yacoolmisaka/sky130-Two-Stage-Miller-OTA/简历项目介绍.md

# SkyWater 130nm 两级 Miller 补偿 OTA

> 作者：桂耀翔
> 定位：IC 版图工程师（模拟/混合信号方向）
> 工艺：SkyWater SKY130 (130nm) 开源 PDK
> 工具链：ngspice / xschem / Magic / netgen / KLayout（全开源）
> 状态：**全流程闭环**（规格 → 前仿 → 版图 → 签核 → 后仿），收官 2026-09-22

---

## 一、一句话

在开源 130nm 工艺上，独立完成两级 Miller 补偿 OTA 的全流程：手算尺寸 → 原理图 → 前仿达标 → Magic 版图 → DRC/LVS 签核 → 含寄生后仿。

---

## 二、电路参数

### 拓扑

- 第一级：M1/M2 NMOS 差分输入对 + M3/M4 PMOS 电流镜负载 + M5 尾电流源
- 第二级：M6 PMOS 共源放大 + M7 NMOS 电流沉
- 补偿：Cc 1.2 pF 串联 Rz 3 kΩ（把 RHP 零点推到左半平面）
- 偏置：外部 10 µA 基准 → Mref 二极管接法 → vbias → M5/M7 镜像
- 电源：1.8 V；负载：2 pF

### 器件尺寸

| 器件 | 类型 | 等效总宽 | L | 指 / 倍数 |
|---|---|---|---|---|
| M1, M2 | NMOS | 4 µm | 1 µm | 2 指 |
| M3, M4 | PMOS | 4 µm | 1 µm | 2 指 |
| M5 | NMOS | 24 µm | 1 µm | 12 指 |
| M6 | PMOS | 56 µm | 1 µm | 28 指 |
| M7 | NMOS | 62.5 µm | 1 µm | 25 指 |
| Mref | NMOS | 12.5 µm | 1 µm | 5 指 |
| Cc | MIM 电容 | 24.3 × 24.3 µm（≈1.2 pF） | — | — |
| Rz | 高阻 poly | W 0.69 µm / L 1.035 µm（≈3 kΩ） | — | — |

### 版图参数

| 项 | 值 |
|---|---|
| 顶层单元 | `ota2_miller` |
| 器件数 | 10 |
| 整体尺寸 | 88 µm |
| 布线层 | metal1 ~ metal4（VDD 走 metal1 / GND 走 metal2） |
| 特殊结构 | 输出节点 via2+via3 叠放、补偿节点 via1+via2 叠放 |
| GDS | 9 cell / 14 层号 / 约 7300 shape |

---

## 三、成绩单

### 前仿（8 项全达标）

| 指标 | 目标 | 实测 |
|---|---|---|
| 开环增益 Av | ≥ 60 dB | **72.65 dB** |
| 单位增益带宽 GBW | 10 ~ 20 MHz | **10.39 MHz** |
| 相位裕度 PM | ≥ 60° | **63.28°** |
| 压摆率 SR | ≥ 10 V/µs | **+14.1 / −12.3 V/µs** |
| 静态功耗 | ≤ 150 µW | **139.7 µW** |
| 输入共模范围 | 0.78 ~ 1.45 V | **0.21 ~ 1.80 V** |
| 阶跃过冲 | 小 | **0.0 %** |
| 工作区 | 全部饱和 | **8/8 饱和** |

### 原理图 ↔ 网表交叉验证

| 指标 | 手写网表 | 原理图导出网表 | 偏差 |
|---|---|---|---|
| Av | 72.65 dB | 72.649 dB | 0.001 dB |
| GBW | 10.39 MHz | 10.41 MHz | +0.2 % |
| PM | 63.28° | 64.37° | +1.09° |

### 签核

| 项 | 工具 | 结果 |
|---|---|---|
| LVS | netgen | **Circuits match uniquely.**（10 器件 / 10 网） |
| DRC | KLayout 官方 `sky130A_mr.drc` | **0 违规** |
| DRC | Magic | 132 → 68 项（剩余为 PDK 器件生成器固有几何） |

### 含寄生后仿

| 指标 | 前仿 | 后仿 | 变化 |
|---|---|---|---|
| Av | 72.65 dB | **72.65 dB** | 持平 |
| GBW | 10.39 MHz | **9.92 MHz** | −4.5 % |
| PM | 63.28° | **64.56°** | +1.28° |

---

## 四、关键操作

```bash
# 前仿
bash 04_sim/run.sh ac

# 版图：magic tkcon 内
source 05_layout/run_lvs.tcl     # 应用修正 → 提取 → 导出网表
source 05_layout/run_gds.tcl     # 导出 GDS
source 05_layout/run_pext.tcl    # 导出含寄生网表（须新开会话）

# LVS / DRC / 后仿
bash run_netgen.sh
bash run_drc.sh
bash run_postsim.sh
```

---

## 五、文件索引

| 路径 | 内容 |
|---|---|
| `01_spec/` `02_sizing/` | 设计规格、手算 sizing 脚本与结果 |
| `03_sch/` | xschem 原理图、网表、接线核验 |
| `04_sim/` | 测试台、模型指向、仿真一键脚本、波特图 |
| `05_layout/` | 版图脚本（TCL / Python）、`mag/` 版图源与 GDS |
| `05_layout/docs/` | 版图与 DRC/LVS 过程记录（10 份） |
| `docs/工程全流程复盘.md` | 全流程复盘 + 技术问答 |
| `README.md` | 项目总览 |
| `lvs*.log` | 13 轮 LVS 迭代日志（含失败轮次，最终版为 `lvs_report.log`） |
| `drc_klayout.txt` | KLayout 签核 DRC 报告 |
