yacoolmisaka/sky130-Two-Stage-Miller-OTA/Screenshot/9.10/AC增益.png

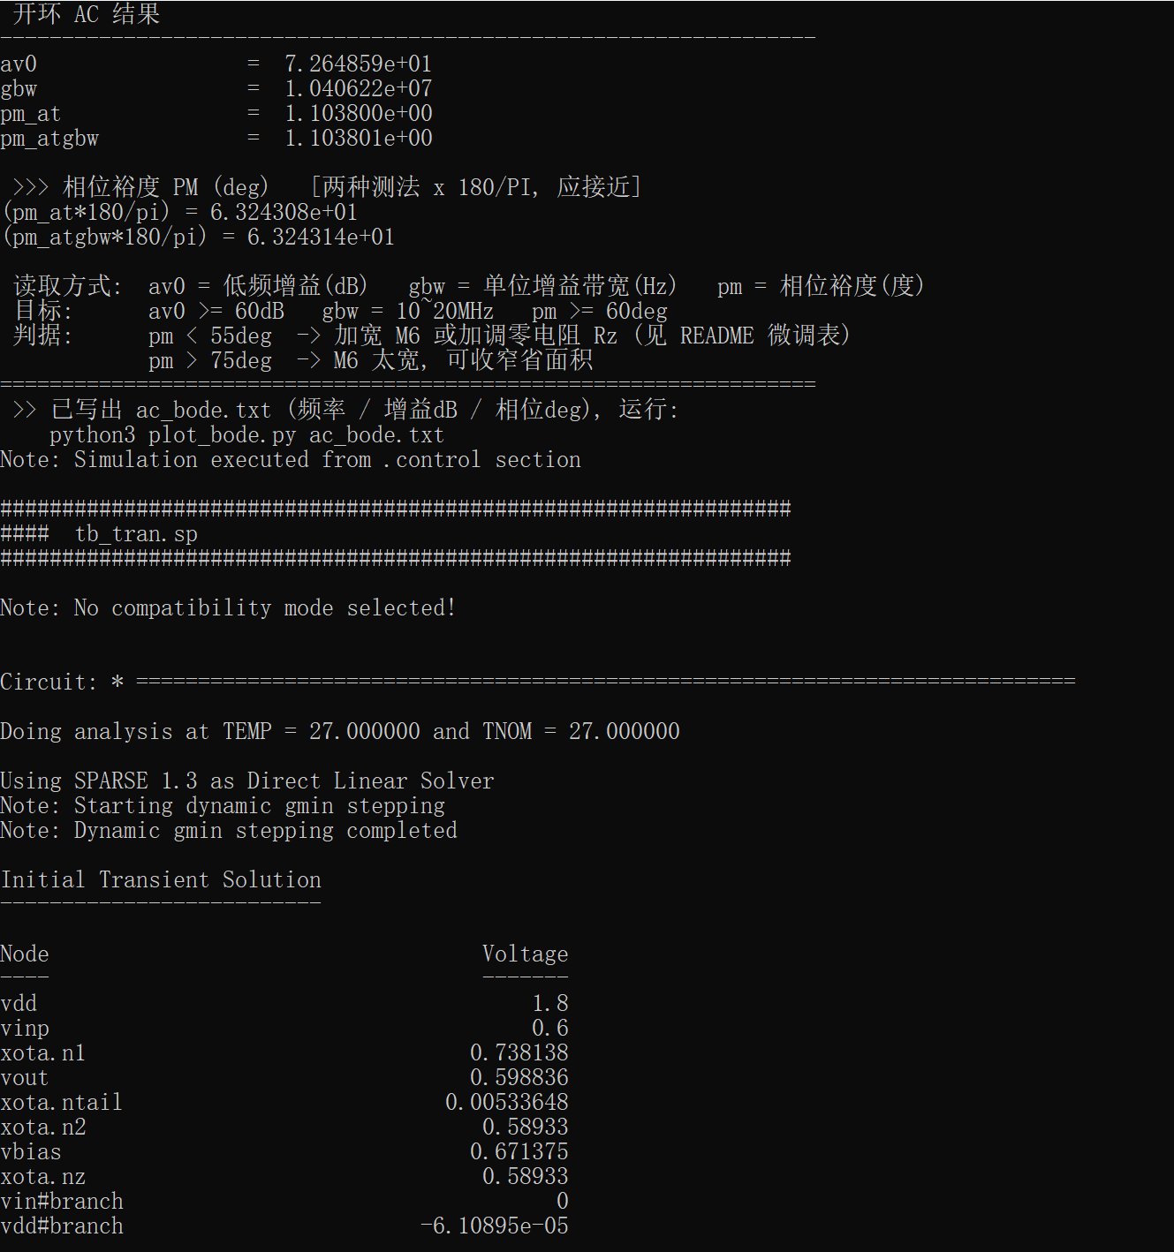
Screenshot/9.10/AC增益.png
