yacoolmisaka/sky130-Two-Stage-Miller-OTA/Screenshot/9.10/OP 工作点2.png

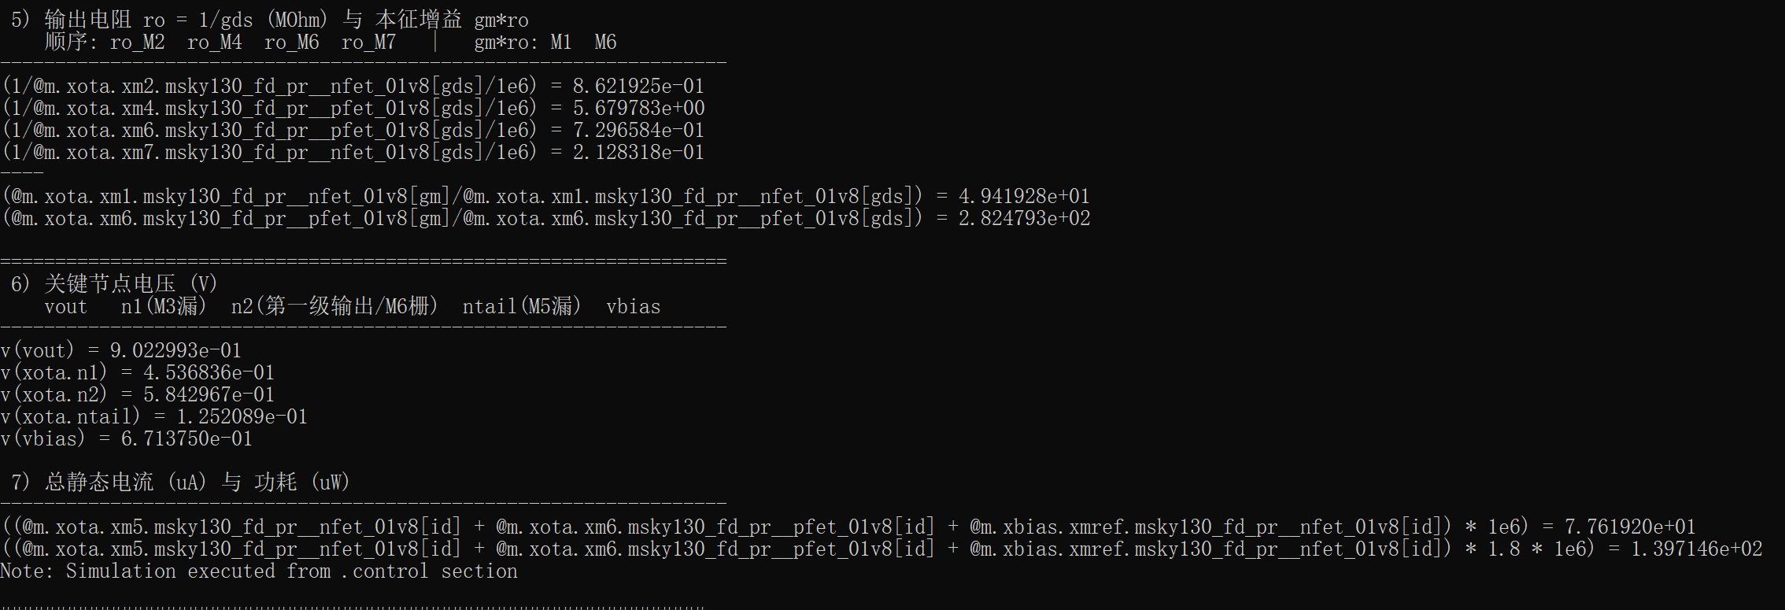
Screenshot/9.10/OP 工作点2.png
