yacoolmisaka/sky130-Two-Stage-Miller-OTA/Screenshot/9.10/PM验算_ICMR报告.png

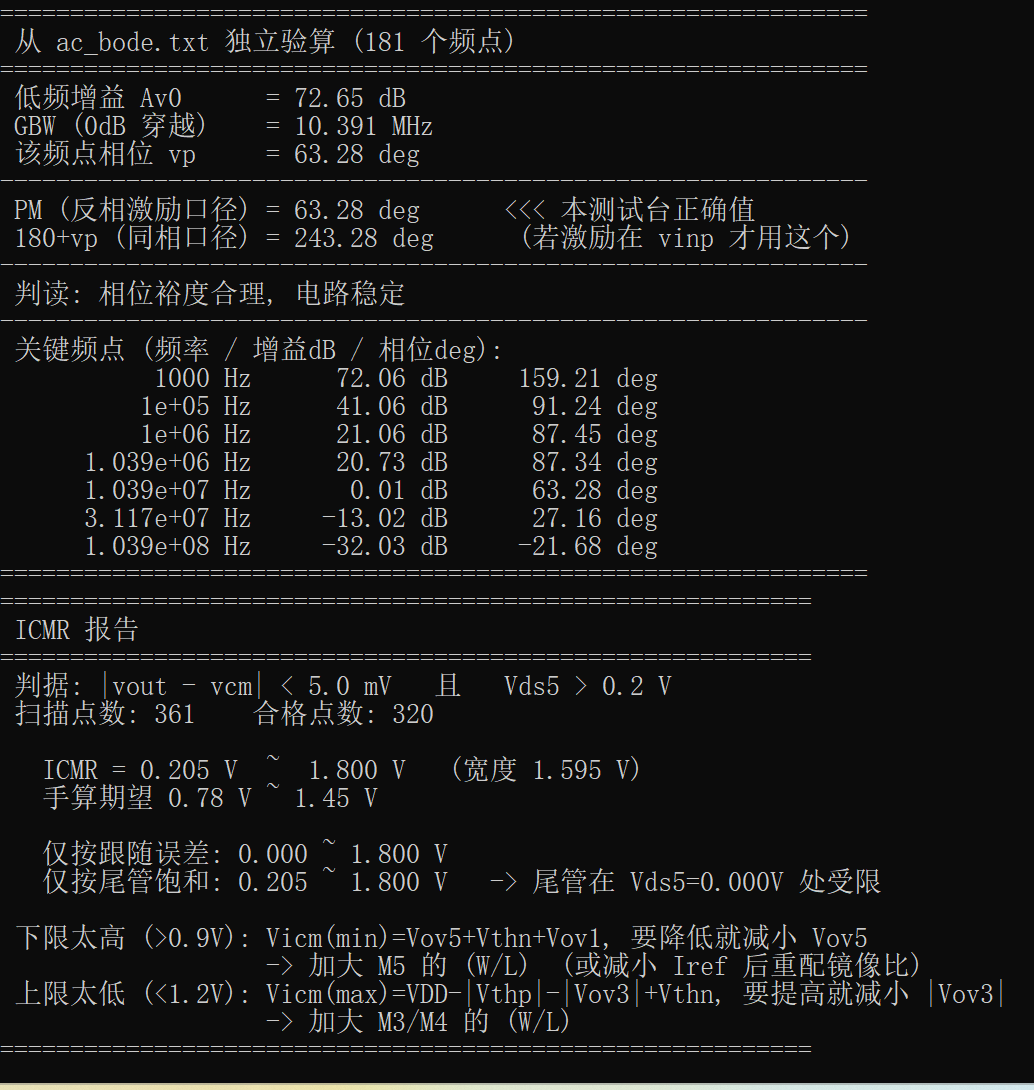
Screenshot/9.10/PM验算_ICMR报告.png
