yacoolmisaka/sky130-Two-Stage-Miller-OTA/Screenshot/9.10/前仿1.png

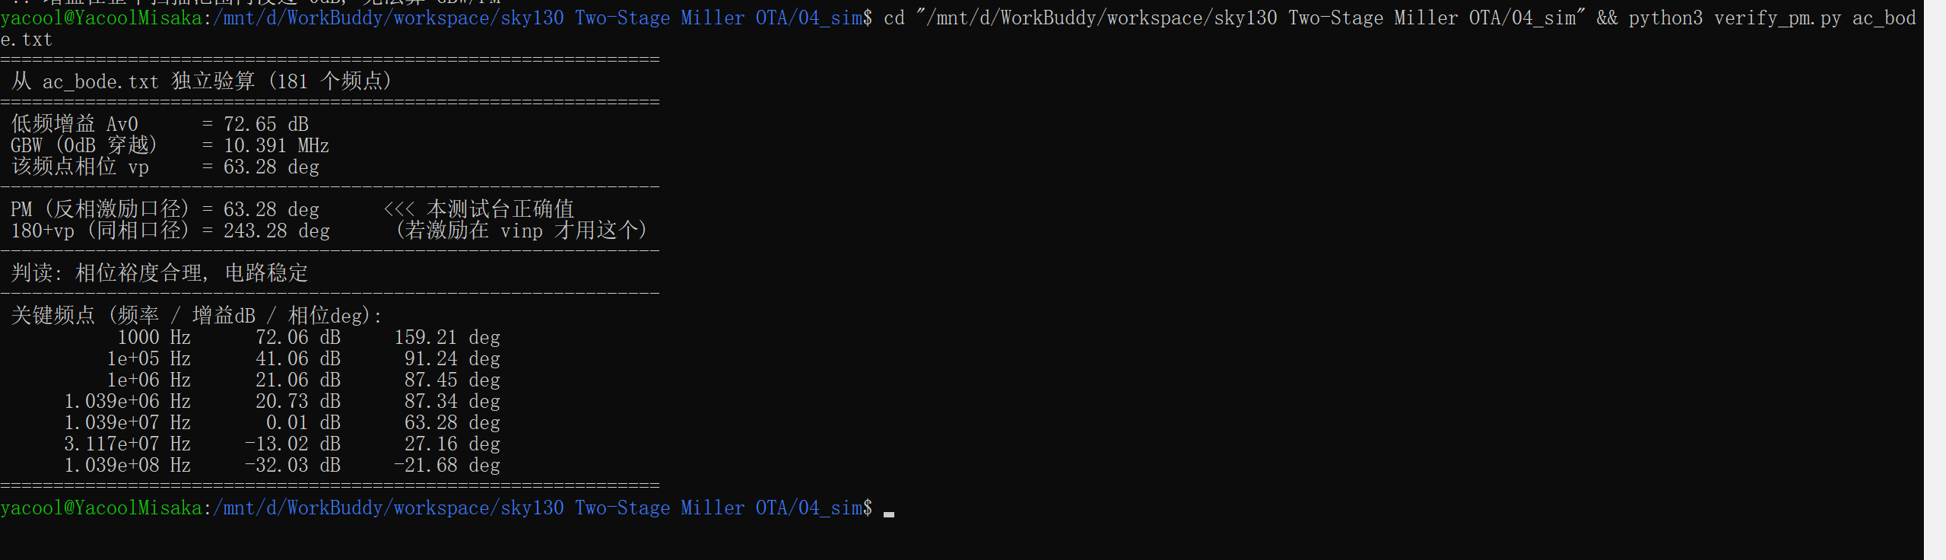
Screenshot/9.10/前仿1.png
