yacoolmisaka/sky130-Two-Stage-Miller-OTA/Screenshot/9.10/前仿2.png

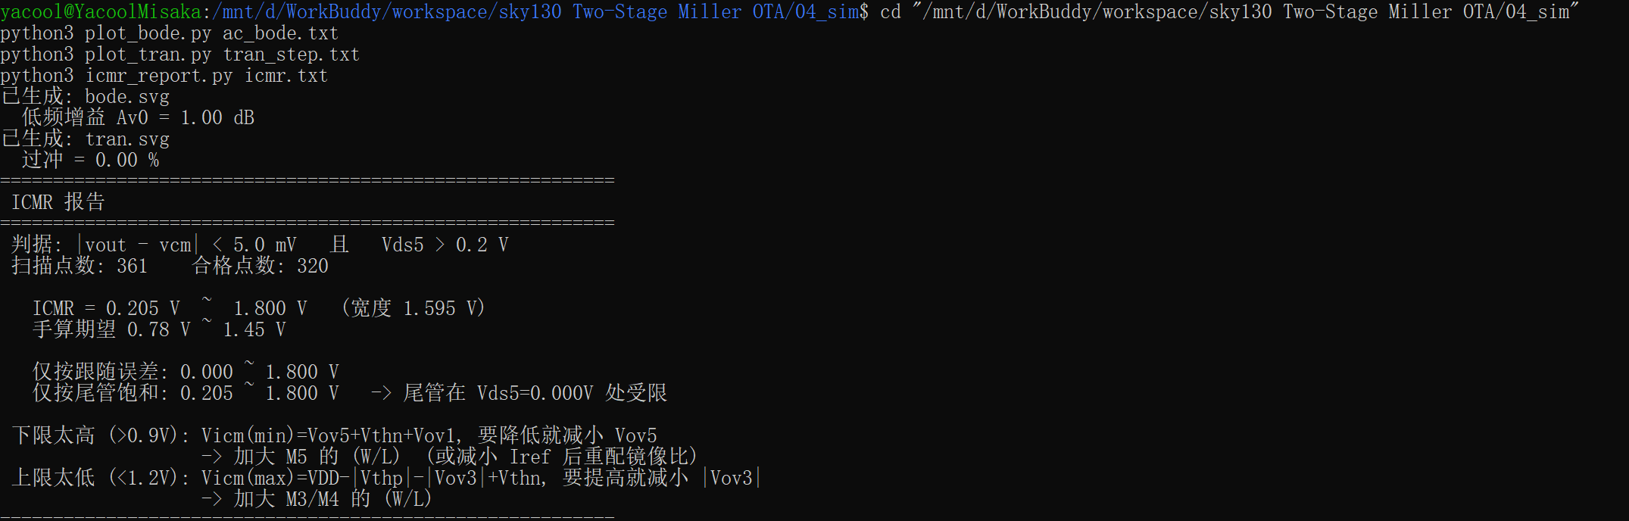
Screenshot/9.10/前仿2.png
