yacoolmisaka/sky130-Two-Stage-Miller-OTA/Screenshot/9.10/屏幕截图 2026-09-10 223026.png

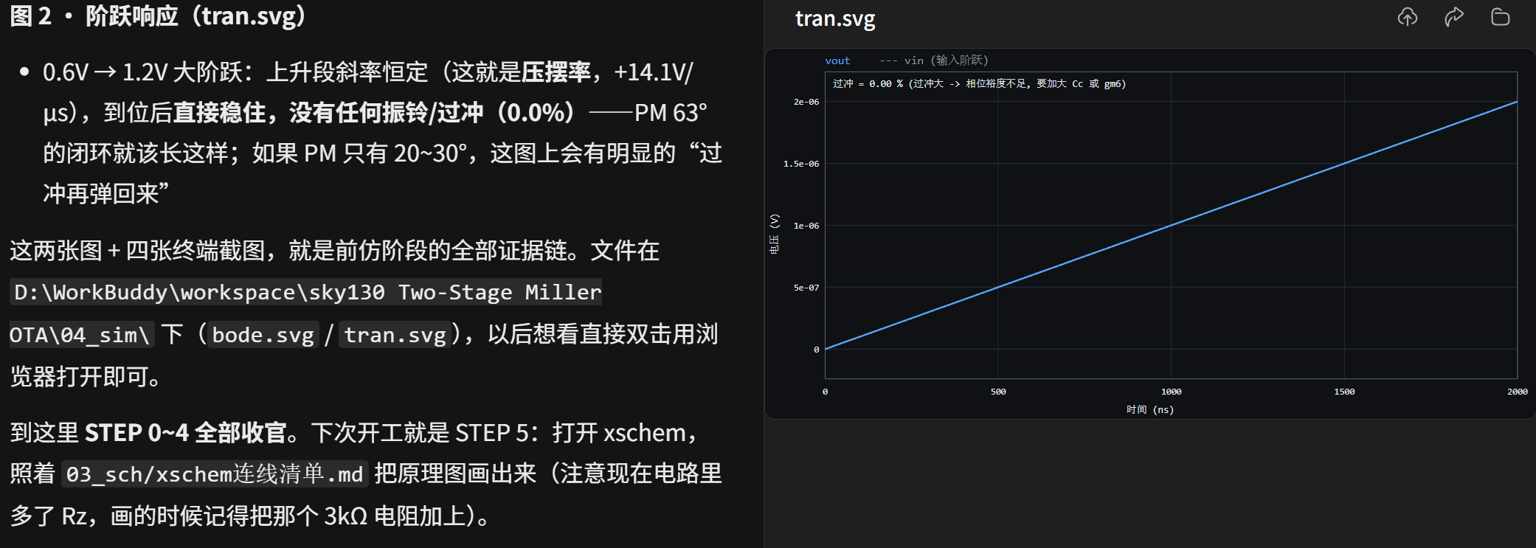
Screenshot/9.10/屏幕截图 2026-09-10 223026.png
