yacoolmisaka/sky130-Two-Stage-Miller-OTA/Screenshot/9.10/电流倍增因子.png

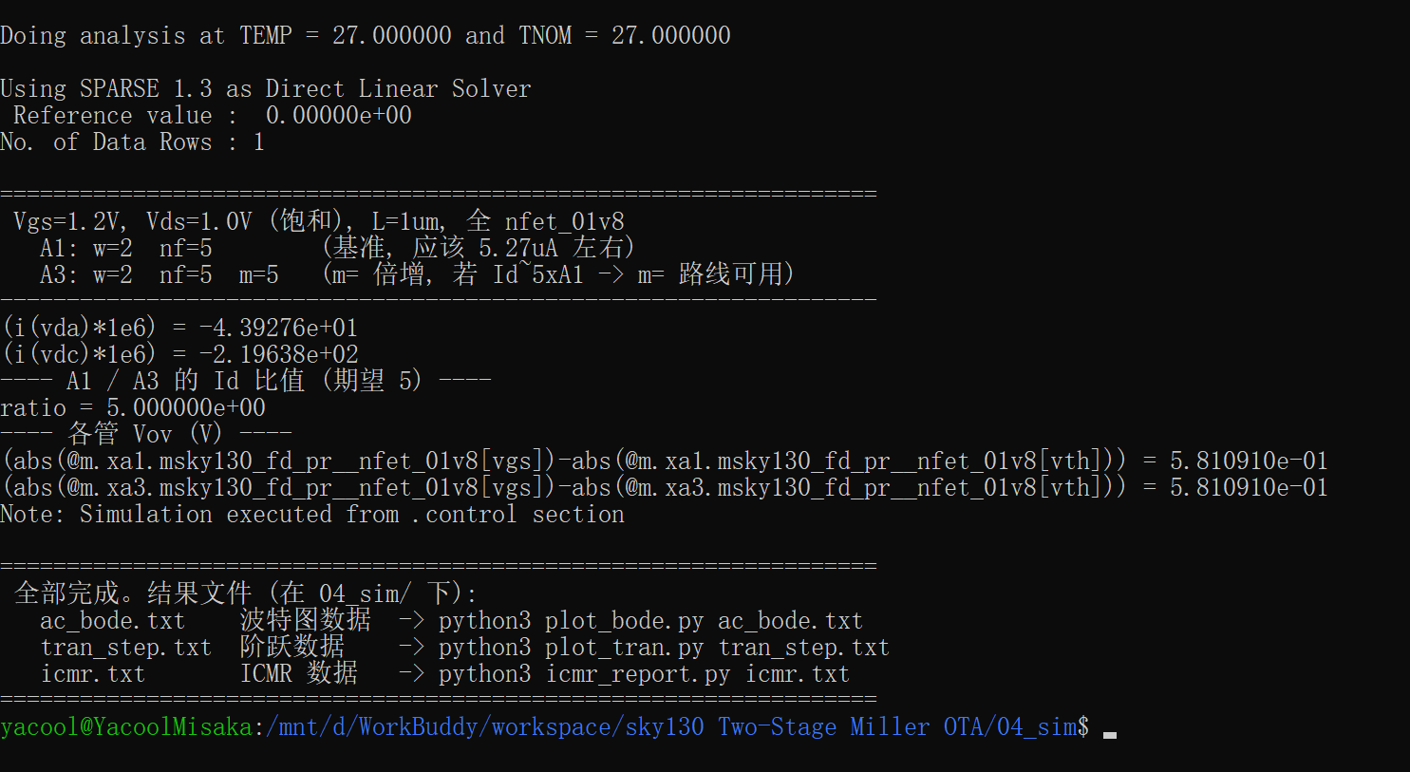
Screenshot/9.10/电流倍增因子.png
