yacoolmisaka/sky130-Two-Stage-Miller-OTA/Screenshot/9.16/xschem画原理图.png

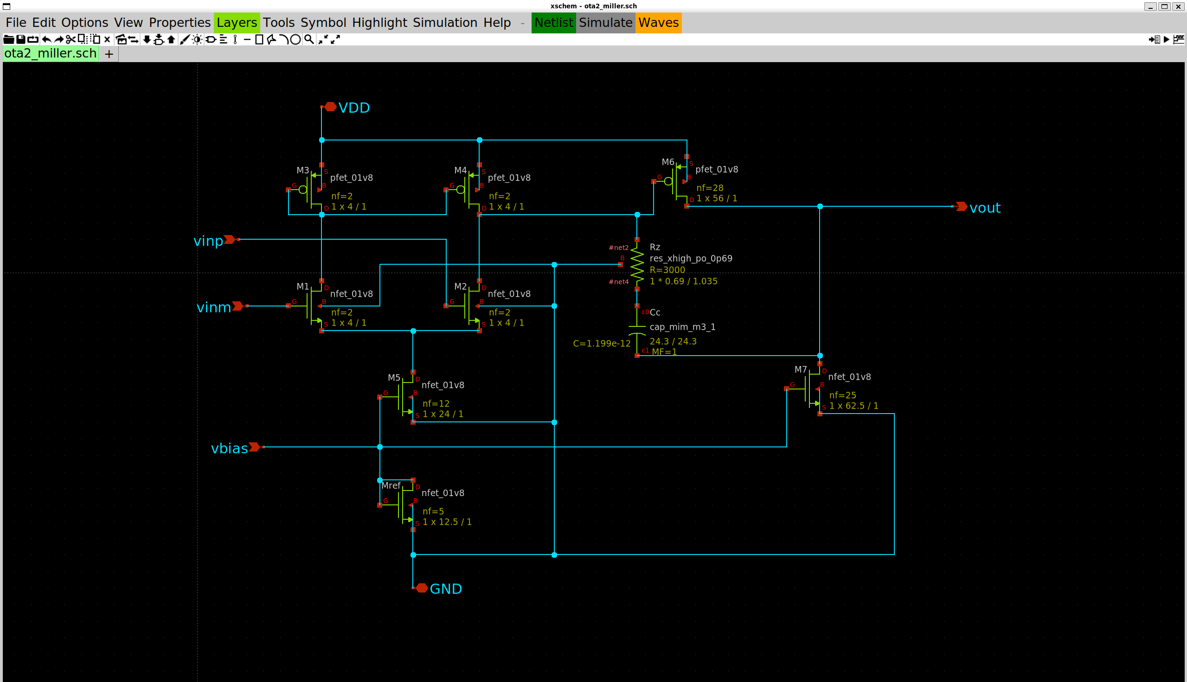
Screenshot/9.16/xschem画原理图.png
