yacoolmisaka/sky130-Two-Stage-Miller-OTA/Screenshot/9.16/交叉验证1.png

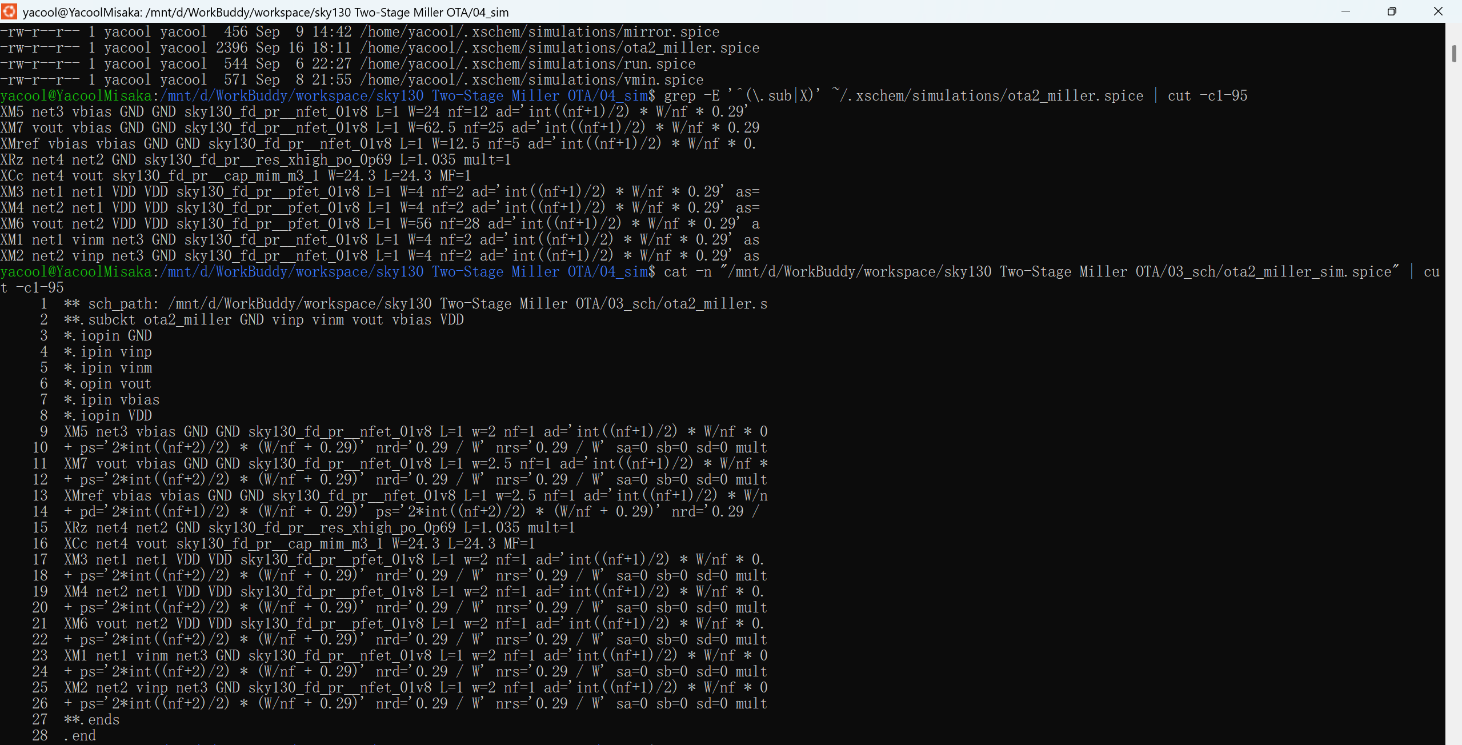
Screenshot/9.16/交叉验证1.png
