yacoolmisaka/sky130-Two-Stage-Miller-OTA/Screenshot/9.16/交叉验证2.png

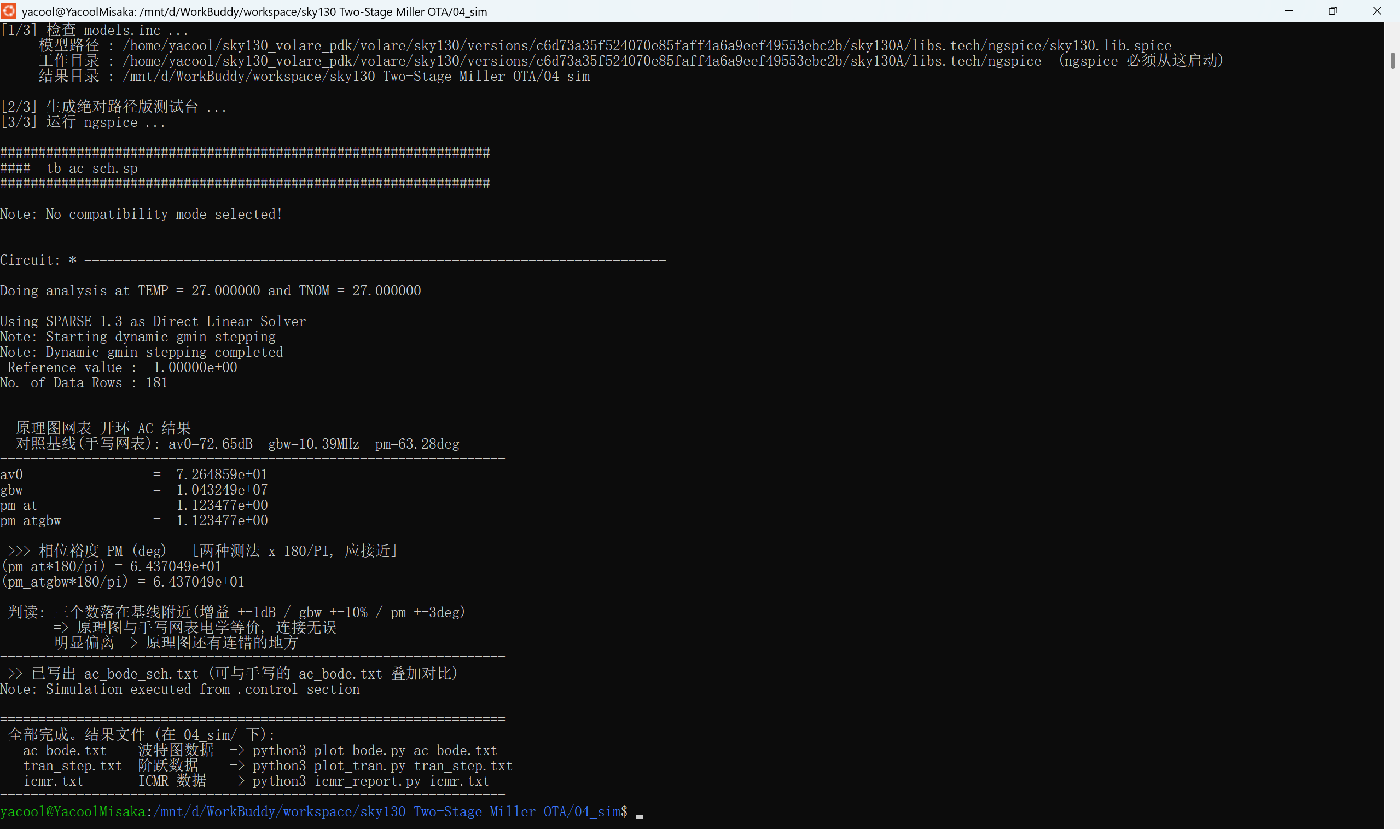
Screenshot/9.16/交叉验证2.png
