yacoolmisaka/sky130-Two-Stage-Miller-OTA/Screenshot/9.19/屏幕截图 2026-09-21 234536.png

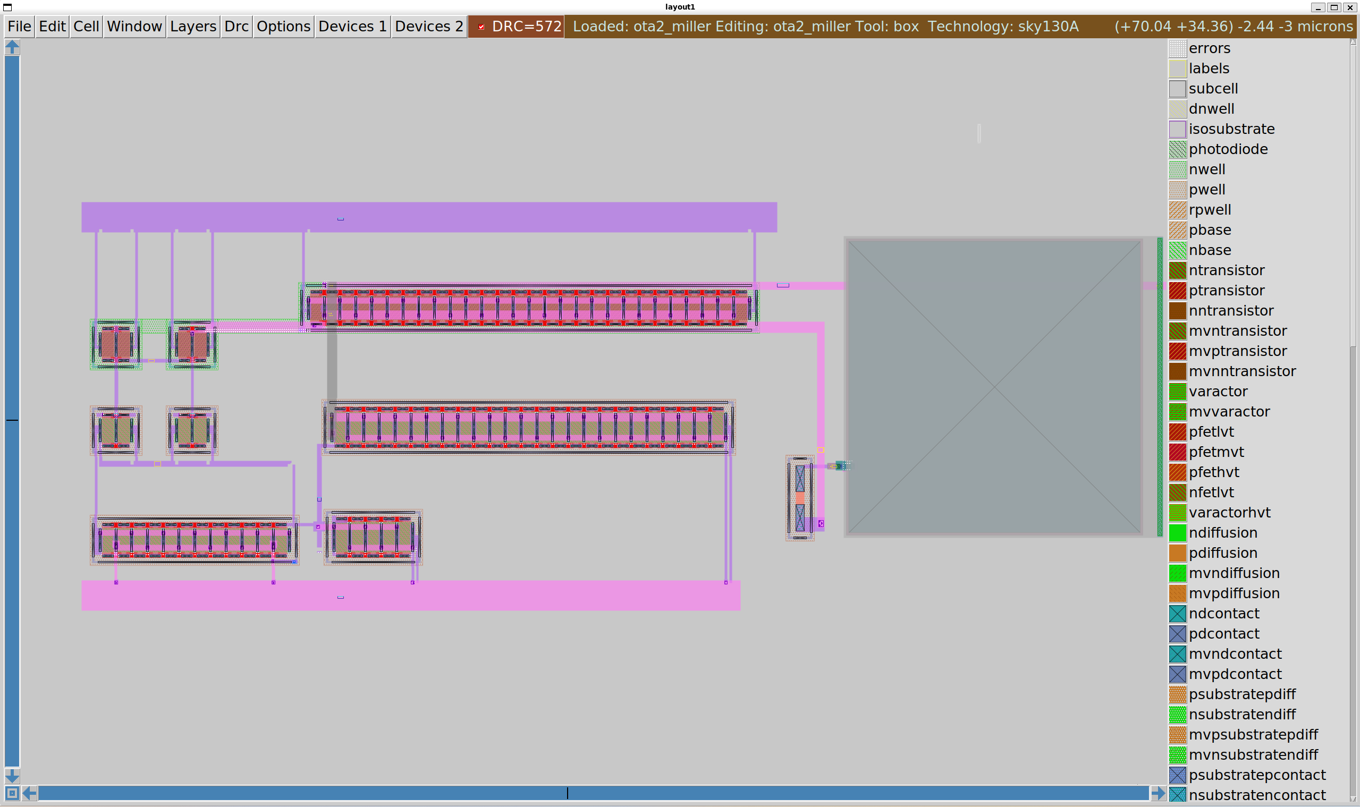
Screenshot/9.19/屏幕截图 2026-09-21 234536.png
