yacoolmisaka/sky130-Two-Stage-Miller-OTA/Screenshot/9.21/屏幕截图 2026-09-21 234447.png

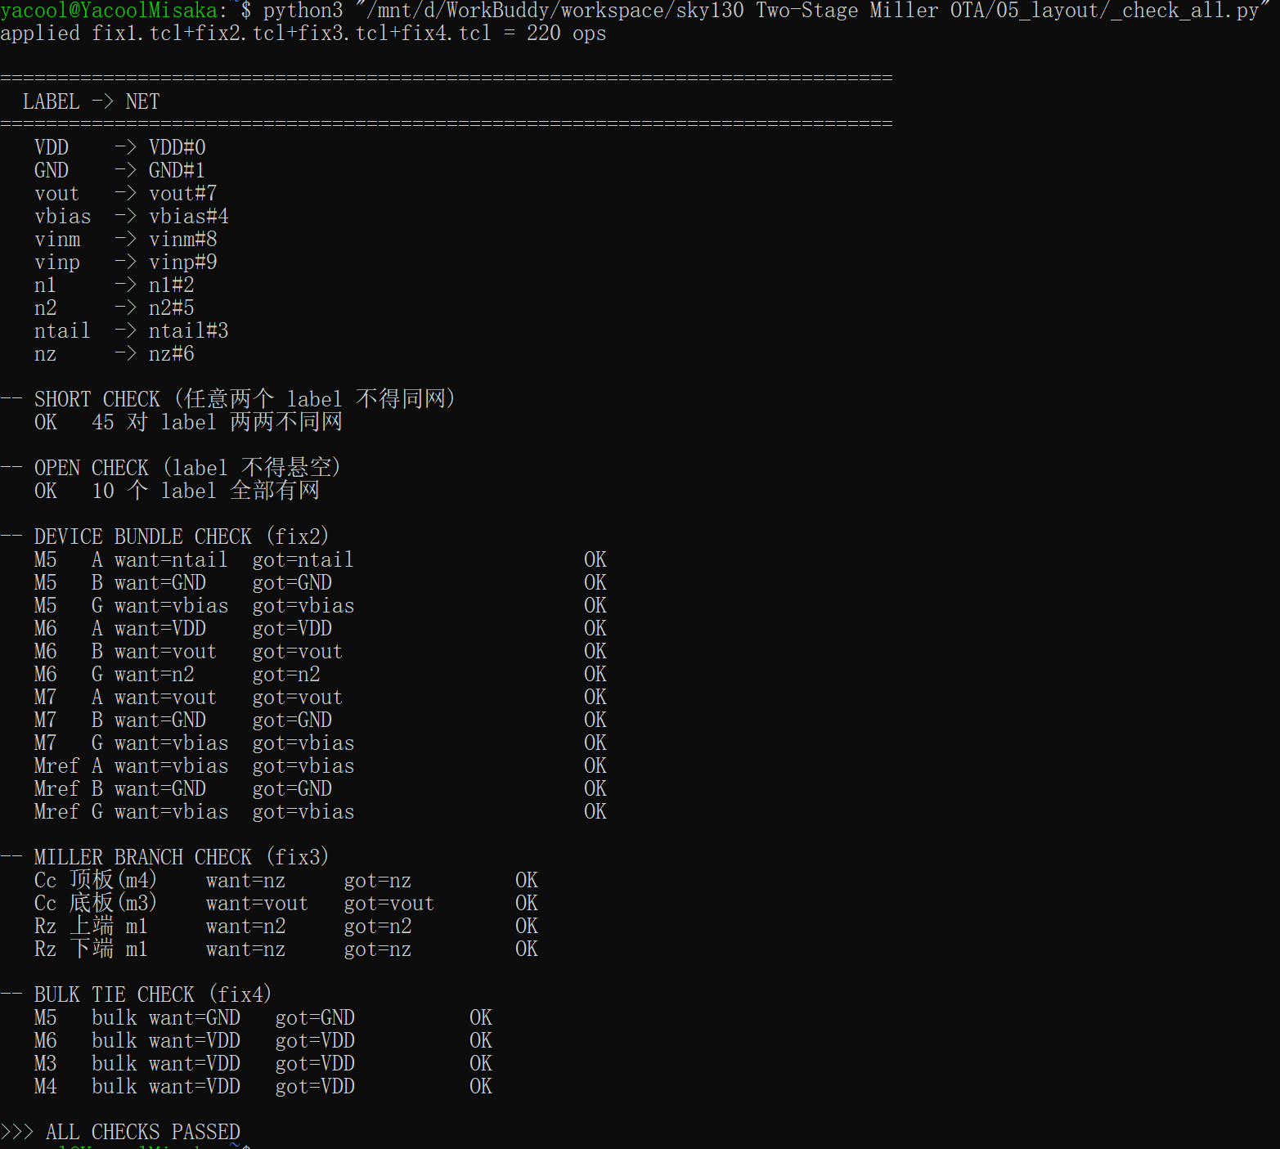
Screenshot/9.21/屏幕截图 2026-09-21 234447.png
