yacoolmisaka/sky130-Two-Stage-Miller-OTA/04_sim/tran_step.txt

 0.00000000e+00  0.00000000e+00  0.00000000e+00  5.98836197e-01  0.00000000e+00  6.00000000e-01 
 5.00000000e-11  5.00000000e-11  5.00000000e-11  5.98836197e-01  5.00000000e-11  6.00000000e-01 
 1.00000000e-10  1.00000000e-10  1.00000000e-10  5.98836197e-01  1.00000000e-10  6.00000000e-01 
 2.00000000e-10  2.00000000e-10  2.00000000e-10  5.98836197e-01  2.00000000e-10  6.00000000e-01 
 4.00000000e-10  4.00000000e-10  4.00000000e-10  5.98836197e-01  4.00000000e-10  6.00000000e-01 
 8.00000000e-10  8.00000000e-10  8.00000000e-10  5.98836197e-01  8.00000000e-10  6.00000000e-01 
 1.60000000e-09  1.60000000e-09  1.60000000e-09  5.98836197e-01  1.60000000e-09  6.00000000e-01 
 3.20000000e-09  3.20000000e-09  3.20000000e-09  5.98836197e-01  3.20000000e-09  6.00000000e-01 
 6.40000000e-09  6.40000000e-09  6.40000000e-09  5.98836197e-01  6.40000000e-09  6.00000000e-01 
 1.14000000e-08  1.14000000e-08  1.14000000e-08  5.98836197e-01  1.14000000e-08  6.00000000e-01 
 1.64000000e-08  1.64000000e-08  1.64000000e-08  5.98836197e-01  1.64000000e-08  6.00000000e-01 
 2.14000000e-08  2.14000000e-08  2.14000000e-08  5.98836197e-01  2.14000000e-08  6.00000000e-01 
 2.64000000e-08  2.64000000e-08  2.64000000e-08  5.98836197e-01  2.64000000e-08  6.00000000e-01 
 3.14000000e-08  3.14000000e-08  3.14000000e-08  5.98836197e-01  3.14000000e-08  6.00000000e-01 
 3.64000000e-08  3.64000000e-08  3.64000000e-08  5.98836197e-01  3.64000000e-08  6.00000000e-01 
 4.14000000e-08  4.14000000e-08  4.14000000e-08  5.98836197e-01  4.14000000e-08  6.00000000e-01 
 4.64000000e-08  4.64000000e-08  4.64000000e-08  5.98836197e-01  4.64000000e-08  6.00000000e-01 
 5.14000000e-08  5.14000000e-08  5.14000000e-08  5.98836197e-01  5.14000000e-08  6.00000000e-01 
 5.64000000e-08  5.64000000e-08  5.64000000e-08  5.98836197e-01  5.64000000e-08  6.00000000e-01 
 6.14000000e-08  6.14000000e-08  6.14000000e-08  5.98836197e-01  6.14000000e-08  6.00000000e-01 
 6.64000000e-08  6.64000000e-08  6.64000000e-08  5.98836197e-01  6.64000000e-08  6.00000000e-01 
 7.14000000e-08  7.14000000e-08  7.14000000e-08  5.98836197e-01  7.14000000e-08  6.00000000e-01 
 7.64000000e-08  7.64000000e-08  7.64000000e-08  5.98836197e-01  7.64000000e-08  6.00000000e-01 
 8.14000000e-08  8.14000000e-08  8.14000000e-08  5.98836197e-01  8.14000000e-08  6.00000000e-01 
 8.64000000e-08  8.64000000e-08  8.64000000e-08  5.98836197e-01  8.64000000e-08  6.00000000e-01 
 9.14000000e-08  9.14000000e-08  9.14000000e-08  5.98836197e-01  9.14000000e-08  6.00000000e-01 
 9.64000000e-08  9.64000000e-08  9.64000000e-08  5.98836197e-01  9.64000000e-08  6.00000000e-01 
 1.00000000e-07  1.00000000e-07  1.00000000e-07  5.98836197e-01  1.00000000e-07  6.00000000e-01 
 1.00500000e-07  1.00500000e-07  1.00500000e-07  5.98818990e-01  1.00500000e-07  6.15000000e-01 
 1.01500000e-07  1.01500000e-07  1.01500000e-07  5.98735097e-01  1.01500000e-07  6.45000000e-01 
 1.03500000e-07  1.03500000e-07  1.03500000e-07  5.98581426e-01  1.03500000e-07  7.05000000e-01 
 1.06707641e-07  1.06707641e-07  1.06707641e-07  6.00857068e-01  1.06707641e-07  8.01229238e-01 
 1.10731309e-07  1.10731309e-07  1.10731309e-07  6.15426107e-01  1.10731309e-07  9.21939271e-01 
 1.15731309e-07  1.15731309e-07  1.15731309e-07  6.58657582e-01  1.15731309e-07  1.07193927e+00 
 1.20000000e-07  1.20000000e-07  1.20000000e-07  7.12380591e-01  1.20000000e-07  1.20000000e+00 
 1.20500000e-07  1.20500000e-07  1.20500000e-07  7.19298075e-01  1.20500000e-07  1.20000000e+00 
 1.21500000e-07  1.21500000e-07  1.21500000e-07  7.33284268e-01  1.21500000e-07  1.20000000e+00 
 1.23500000e-07  1.23500000e-07  1.23500000e-07  7.61886438e-01  1.23500000e-07  1.20000000e+00 
 1.27500000e-07  1.27500000e-07  1.27500000e-07  8.20216741e-01  1.27500000e-07  1.20000000e+00 
 1.32500000e-07  1.32500000e-07  1.32500000e-07  8.93618640e-01  1.32500000e-07  1.20000000e+00 
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
